xiaoli5201314-spec/rubber-tapping-robot-stm32-rk3588/firmware/chassis_f407/README_CN.md

# STM32F407 履带底盘遥控固件

本工程是一个面向 STM32F407 的双路 D60A 电机驱动固件：接收遥控器 CH1（转向）、CH2（油门）和 CH5（解锁），经过安全状态机后驱动左、右两个直流电机。串口会输出输入信号、安全状态和两路输出，便于调试。

## 首版范围

- 支持 50 Hz 模拟舵机脉宽输入：CH1、CH2、CH5。
- 支持 D60A 两路方向 + PWM 控制，MA 为左电机，MB 为右电机。
- 上电默认锁定；CH1/CH2 回中、CH5 解锁并保持中立 1 秒后才允许驱动。
- 输入失效、超时或捕获溢出时立即刹车；重新恢复后必须先断开 CH5，再重新完成中立保持。
- 默认输出上限为 30%，换向时先降到零并刹车 50 ms。
- USART1 以 115200 波特率输出诊断行；没有编码器，因此只能把 PWM 输出百分比当作“输出量”，不能当作实际速度。

以下功能不属于首版：LCD/触摸、雷达、视觉、切割机构等。首版电机引脚与板上的摄像头/OLED 接口复用，请不要同时连接这些模块。

## 快速开始

1. 先阅读 [Docs/WIRING_CN.md](Docs/WIRING_CN.md)，断开 24 V 电机电源，完成接线、P2 跳帽和共地检查。
2. 按 [Docs/TEST_GUIDE_CN.md](Docs/TEST_GUIDE_CN.md) 配置遥控器，并依次完成串口、无电机、抬高底盘和低速落地测试。
3. 使用工程现有的 Keil/STM32 工具编译并下载；串口终端选择 UART1、115200、8-N-1。
4. 上电顺序始终为：在接线和准备过程中先保持“发射机/接收机关闭”或“CH5 处于 disarm” → 给 STM32/接收机接通低压电源 → 通过串口确认 `LOCKED`/`FAILSAFE` 且两路为 `BRAKE` → 最后才接通带保险和急停的 24 V 电机母线。

> **安全警告**：首次通电必须拆下电机或让履带完全离地；现场应有保险丝、总电源开关和伸手可及的急停。绝不能把 24 V 直接接到 STM32 或接收机的 5 V/低压端。

详细连接关系见 [WIRING_CN.md](Docs/WIRING_CN.md)，分阶段上电和验收步骤见 [TEST_GUIDE_CN.md](Docs/TEST_GUIDE_CN.md)。
