xiaoli5201314-spec/rubber-tapping-robot-stm32-rk3588/docs/progress.md

# 项目进度

更新时间：2026-10-15。此页用于持续更新实际工作，分别记录软件检查、台架观察和未完成事项，不以“已有设计”代替实物验收。

| 部分 | 当前进度 | 边界 / 下一步 |
| --- | --- | --- |
| 自制 STM32F407 板 | 已开展焊接和上电检查，提供独立 LED 测试工程 | 不是整机长期可靠性验收 |
| USB / 调试串口 | 已完成 CH340N / UART 通信阶段检查，保留 UART4 检查源码 | 继续核对整机布线、共地和抗干扰 |
| ESP-12F、Wi-Fi、MQTT | 已建立 MQTT 联调主线，支持 SESSION、心跳、重连与 LED 自检 | 热点已关联、设备在线和本次自检成功分别判断 |
| 接收器 PWM | 已接入 CH1/CH2/CH5，完成输入和本地锁定/解锁逻辑开发 | 接收器自身失控保护须单独核验 |
| 履带底盘 | 已开展底盘离地遥控试验，提供失效停车和换向保护源码 | 未据此宣称带载地面行驶或整机作业通过 |
| 30% / 60% / 100% 输出 | 已开展三个 PWM 上限的对比测试并保留三个独立目标 | PWM 上限不等于车速、电流限制或实际负载能力 |
| 动力供电 | 已定位现有 24 V / 5.1 A 电源对后续带载测试的限制 | 尚未完成电池、电流裕量、保护及带载供电验收；常规后续试验优先按已记录的 60% 阶段方案审慎推进 |
| 电脑网页监视 | 已有实时状态、遥控/输出显示、离线撤销与受限 LED 自检 | 网页不发送运动、解锁或切割命令 |
| RK3588 / ROS 2 | Ubuntu 24.04 / ROS 2 Jazzy 软件环境已完成节点通信、C++ 编译运行、重启回连等软件侧检查 | 不代表传感器、实际串口或完整机器人系统已经接入 |
| 四柱升降机构 CAD | 已形成概念布局，保留 Fusion 生成脚本 | 导轨、丝杆、驱动、限深、防坠与加工图尚待工程化；不按概念模型直接加工 |
| 雷达、摄像头、视觉 / 导航 | 已有独立开发或方案准备 | 尚未在本割胶机器人完成实物集成和整车验收 |
| 割胶执行与胶层控制 | 尚未验证 | 需完成机构、限深/仿形、安全联锁与真实作业试验 |

## 已公开的工作

代码以当前工作文件整理：基础底盘、安全状态机、各板级检查工程、五个 MQTT 目标、Python 服务、网页界面、测试和机械概念脚本。原始私人对话、个人文档、论文、运行日志和厂商大包不随源码发布。

本次公开副本的软件回归结果在 [VALIDATION.md](VALIDATION.md)，与本页历史台架进度分别记录。本次发布没有再次连接硬件，也没有烧录或发送运动指令。

## 后续更新方式

每次完成新工作，更新上方日期和对应行，注明具体环境、验证方法和剩余限制；新的软件回归结果写入 `VALIDATION.md`。只有真实完成的硬件验收才将相应条目改为通过。
