xiaoli5201314-spec/rubber-tapping-robot-stm32-rk3588/firmware/chassis_f407/Docs/TEST_GUIDE_CN.md

# 安全上电与分阶段测试指南

本指南假设已经完成 [WIRING_CN.md](WIRING_CN.md) 的接线。每一步都要有保险丝、总开关和伸手可及的急停；任何人靠近履带时都必须先断开 24 V 母线。

## 遥控器设置

1. 发射机/接收机使用 **50 Hz 模拟舵机模式，180°**。
2. CH1 映射为转向，CH2 映射为油门；两者机械中位应约为 1500 us。
3. 将三段开关 SWA 映射到 CH5。默认高电平有效，CH5 脉宽达到 **1700 us 或更高**才算解锁。
4. 设定失控保护（failsafe）：CH1=1500 us、CH2=1500 us、CH5=disarm（低于 1700 us，例如约 1000 us）。
5. 首次接电机前，关闭发射机或关闭接收机，确认系统在串口中进入 FAILSAFE/锁定并保持刹车；确认后再继续。

固件要求 CH1、CH2、CH5 三路都有效且新鲜：先将 CH5 置于断开端并让 CH1/CH2 保持 1450–1550 us 中立进入 WAIT，连续保持 1 秒后再将 CH5 拨到解锁端，才会进入 ARMED。输入超时（默认 100 ms）、无效或捕获溢出会立即刹车；恢复信号后必须先将 CH5 置于断开端，再重新完成 1 秒中立保持。

## 串口诊断格式

UART1：115200、8-N-1。约每 200 ms 输出一行，字段包括：

`t` 时间；`ch1/ch2/ch5` 脉宽（us）；每路 `v` 有效标志、`f` 新鲜标志；`state` 为 `LOCKED`、`WAIT`、`ARMED` 或 `FAILSAFE`；`lt/rt` 左右目标输出；`ld/rd` 方向（`FWD`、`REV`、`BRAKE`）；`lp/rp` PWM 输出千分比；`fault` 故障原因。

没有编码器，`lp/rp` 只是控制输出百分比，不是实际转速。刹车在 D60A 上表现为方向输入 `00` 且 PWM=0。换向时先缓降到 0，再保持 50 ms 刹车后才允许反向；默认最大输出为 300‰（30%）。

## 分阶段测试

每一阶段都必须满足“预期现象”后才能进入下一阶段。出现任一停止条件，立即执行“急停动作”，记录串口最后一行，再断电排查。

### 1. 仅逻辑/串口测试（不接 24 V，不接电机）

**接线与电源状态**：电机从 D60A 脱开，24 V 母线断开；只给 STM32 和接收机低压供电，连接 USB-UART 到 UART1。P2 选 MCU 侧，接收机 GND 与 STM32 GND 共地。

**预期遥测**：接收机关闭或发射机关闭时三路 `v/f` 不全为 1，`state=LOCKED` 或 `FAILSAFE`，`ld=rd=BRAKE` 且 `lp=rp=0`；打开并保持遥控器中立、CH5 断开时先看到 `WAIT`，持续 1 秒后把 CH5 拨到解锁端才看到 `ARMED`。此时即使遥控杆移动，因没有 24 V 和电机也不应有机械动作。

**停止条件与急停**：串口出现输入异常跳变、任何一路 `v=0` 却进入 ARMED、或 LED 与 `state` 不一致，立即关闭低压电源，检查 P2、共地、接收机模式和信号线。不要进入下一阶段。

### 2. D60A 驱动测试（不接电机）

**接线与电源状态**：保持电机断开；接好 D60A 控制排针 2/3/4/5/7/8/9/10，1/6 留空；控制地共地。仅给 STM32、接收机和 D60A 控制侧低压供电，24 V 母线仍断开。

**预期遥测**：安全流程与阶段 1 相同。保持 ARMED 后缓慢拨动 CH1/CH2，`lt/rt` 应按预期正负变化，`ld/rd` 在 FWD/REV 间切换，`lp/rp` 从 0 逐步变化且不超过 300；回中后回到 BRAKE/0。D60A 输出端不应有电机动作。

**停止条件与急停**：任一路方向线与预期相反、PWM 不归零、输出超过 300‰、或未 ARMED 时出现非 BRAKE，立即把 CH5 拨回断开端并切断低压电源；核对 A/B 方向线、PWM 线和 D60A 端子编号。

### 3. 单电机测试（底盘抬起）

**接线与电源状态**：安装并固定 MA（左电机）或 MB（右电机）中的一个，另一个电机线保持断开并绝缘；履带完全离地。控制低压电源先上，确认串口 LOCKED/WAIT；再通过保险丝和急停接通 24 V 母线。

**预期遥测**：CH5 断开、CH1/CH2 中立时必须保持 BRAKE/0。完成解锁后，用很小的油门并按需配合转向短点动；已接电机应按对应方向低速启动，PWM 平滑递增，回中后降到 BRAKE/0。由于固件在 ARMED 时始终同时计算和应用左右两路，遥测中的 `lt/rt`、`lp/rp` 可能两侧都有指令；判断单电机测试通过的条件是物理上已断开的一侧不应转动，而不是要求该侧遥测为 0。关闭发射机或拔掉接收机信号后应立即 FAILSAFE 和刹车。

**停止条件与急停**：电机抖动、持续自转、方向与预期相反、D60A/电机异常发热、保险丝动作、串口出现 FAILSAFE 以外的故障，或电机无法刹停时，立即拨回 CH5、按急停、断开 24 V，再断低压。更换接线前等待电机完全停止。

### 4. 双电机测试（底盘抬起）

**接线与电源状态**：MA 接左路，MB 接右路；底盘稳固抬起，履带不得接触地面。低压先上并确认遥测正常，再接通带保险的 24 V 母线。

**预期遥测**：油门中立时两路 BRAKE/0；仅推油门时 `lt` 与 `rt` 同号且两路 PWM 随斜坡同步增加；仅推转向时两路目标一正一负或一侧减小，方向符合左右履带差速。快速反向时每一路先降到零、刹车约 50 ms，再反向。任何时刻输出不超过 300‰。

**停止条件与急停**：任一侧不同步到无法解释、方向颠倒、换向无刹车、机械碰撞/异常噪声/发热，立即 CH5 断开并按急停。若掉链或结构松动，先断 24 V，禁止用手扶正在转动的履带。

### 5. 低速落地测试

**接线与电源状态**：确认前四阶段通过；底盘放到空旷平整地面，人员站在履带侧后方而非前方。保留保险丝、总开关和急停；低压上电确认 LOCKED/WAIT 后，再接通 24 V。

**预期遥测**：先以最小油门短点动，底盘应按 CH2 前后、CH1 转向移动；松杆回中后两路降为 BRAKE/0。逐步增加时间而不是幅度，始终观察 `state`、`fault`、`lp/rp`，不得把输出百分比当作速度。关闭发射机测试时应在 100 ms 级别内进入 FAILSAFE 并刹车。

**停止条件与急停**：方向无法控制、回中后仍爬行、任何信号 `v/f` 丢失、FAILSAFE 未刹停、温升/异味/异响或人员进入危险区，立即松开遥控器、拨 CH5、按急停并切断 24 V。查明原因并重新从阶段 1 开始，不要直接恢复行驶。

## 可调参数（`App/board_config.h`）

修改后必须重新编译、下载，并重复至少阶段 1–3 的安全验证。

| 符号 | 默认值 | 用途 |
| --- | ---: | --- |
| `RC_STEERING_INVERT` | `0` | CH1 转向方向反相开关 |
| `RC_THROTTLE_INVERT` | `0` | CH2 油门方向反相开关 |
| `MOTOR_LEFT_INVERT` | `0` | 左电机 MA 输出方向反相 |
| `MOTOR_RIGHT_INVERT` | `0` | 右电机 MB 输出方向反相 |
| `RC_CENTER_US` | `1500` | CH1/CH2 中位（us） |
| `RC_DEADBAND_US` | `50` | 中位死区，默认 1450–1550 us |
| `RC_ARM_ACTIVE_HIGH` | `1` | CH5 有效极性；1 表示高脉宽有效 |
| `RC_ARM_THRESHOLD_US` | `1700` | 高有效时 CH5 解锁阈值（us） |
| `RC_TIMEOUT_MS` | `100` | 遥控输入超时（ms） |
| `MOTOR_MAX_OUTPUT_PERMILLE` | `300` | 最大 PWM 输出（千分比） |
| `MOTOR_RAMP_STEP_PER_10MS` | `10` | 每 10 ms 的输出斜坡步长 |
| `MOTOR_REVERSE_BRAKE_MS` | `50` | 换向前归零后的刹车时间（ms） |
| `RC_ARM_NEUTRAL_HOLD_MS` | `1000` | 解锁前 CH1/CH2 中立保持时间（ms） |

不要为了“方便测试”删除安全状态机、绕过 CH5 或把超时设为极大值。任何参数变更都应在抬高底盘状态下重新验证失控保护。
