xiaoli5201314-spec/rubber-tapping-robot-stm32-rk3588/firmware/chassis_f407/Docs/WIRING_CN.md

# 接线说明（STM32F407 自绘底板 + 布瑞特 BRT-HDC-D60A）

本文按“第一次接线”的顺序编写，对应 `选取的stm32/自己已经画的STM32F407的部分/SCH_Schematic1_2026-09-30.pdf`。所有电源关闭、24 V 母线断开并拔掉电机后再改线。

## 重要安全规则

- 24 V 只供电机母线和 D60A 的电机功率侧；STM32 和接收机使用独立、合适的低压电源。
- STM32、接收机和 D60A 控制信号的 GND 必须共地，否则 PWM/方向信号可能漂移或失控。
- 绝不能把 24 V 接到 STM32、接收机 5 V 或任何 MCU 引脚。
- 在电源入口安装符合电流需求的保险丝、总开关和可触及的急停；首次电机测试时底盘必须抬离地面。
- 本固件占用 `CN1`（电机驱动）与 `CN3`（遥控器）两个端子；LCD 座、`U8` I2C1 排针、`J1` 机构口、蜂鸣器、WiFi 模块均不在首版范围内。
- ⚠️ 板上 `U8` 4P 排针引出的是 `I2C1_SCL`/`I2C1_SDA`（已核对为 **PB8/PB9**）。**以后配置 I2C1 时绝不能改到 PB6/PB7**——那两个脚是左右电机的 PWM（TIM4_CH1/CH2），改过去会立刻废掉两路电机驱动。
- ⚠️ 不要把 LCD 触摸（本板触摸脚 29–34 未接）、雷达、视觉和切割模块接进首版固件的引脚。

## 接收机与 STM32

自绘 PCB 上对应 **`CN3` = `DB128V-5.08-5P-GN-S`（5 位端子）**。

| CN3 脚 | 接收机信号 | 网络名 | STM32 引脚 | 用途 |
| ---: | --- | --- | --- | --- |
| 1 | CH1 信号 | `RC_CH1` | PB10 / TIM2_CH3 | 转向 |
| 2 | CH2 信号 | `RC_CH2` | PB11 / TIM2_CH4 | 油门 |
| 3 | CH5 信号 | `RC_CH5` | PF6 / TIM10_CH1 | 解锁/安全开关（SWA） |
| 4 | 5 V | `5V` | — | 接收机供电 |
| 5 | GND | `GND` | — | 与 STM32、D60A 控制地共地 |

**CH5 必须接到 CN3-3**。遥控器把三段开关 SWA 映射到 CH5；先拨到三个位置，用串口确认你打算当“解锁”的那一端脉宽 ≥1700 µs（`board_config.h` 的 `RC_ARM_THRESHOLD_US`），若极性相反就把 `RC_ARM_ACTIVE_HIGH` 改成 `0U`。

固件的 100 ms 超时检查的是“最后有效 PWM”，**并不直接检测遥控器无线失联**。若关掉遥控器后接收机继续保持合法 PWM，固件不会仅因无线断联进入 `FAILSAFE`。说明书有失控保护说明，但本套 F-10A 的实际输出必须先实测：分别验证“关闭发射机”和“断开信号线”；接电机前还必须验证接收器失控保护和硬件急停。

**PWM 输入电平条件：**PB10/PB11/PF6 为 FT 引脚，固件使用数字定时器输入并关闭内部上下拉（`GPIO_NOPULL`），以满足可能为 5 V 的输入要求。ST 数据手册第 78 页要求高于 `VDD+0.3 V` 的输入必须关闭内部上下拉；建议 MCU 侧每路外接约 10 kΩ 下拉到 GND，防止断线后悬空。没装外部下拉时，不应将拔线现象作为失效保护验证结论。接收机本次只用 5 V 供电，不能把 4–9 V 供电范围理解为 MCU 可接受的信号范围。

<details>
<summary>旧版探索者底板遗留说明（自绘 PCB 已不适用）</summary>

探索者 V3 原板的 P2 为 PB10/PB11 在 RS232 与 ATK-MODULE 之间选择连接；直接飞线到 PB10/PB11 时，应断开这些跳帽以隔离外设。PF6 连接 ATK-MODULE KEY，不经过 P2，不要同时连接该模块。自绘 PCB 用独立的 `CN3`（5P 端子）引出 `RC_CH1 / RC_CH2 / RC_CH5 / 5V / GND`，不套用原板跳帽说明。当前原开发板桌面测试另见 `RC_BENCH_TEST_CN.md`。
</details>

**接收机必须工作在「模拟舵机模式 50 Hz」**（HT-10A 说明书 P11）：该模式输出周期 20 ms、脉宽 1000–2000 µs。数字舵机模式为 330 Hz、周期 3.03 ms，会超出固件 15–25 ms 的捕获窗口，导致三路输入全部无效、底盘永远无法解锁。遥控器菜单里确认「舵机频率 50 Hz、舵机角度 180°」。

**接收机供电范围 DC 4–9 V**（说明书 P12），本板 `CN3-4` 提供 5 V，符合要求；不得接入 24 V 母线。

**必须使用 PWM 接收机（F-10A）**。随附的 SBUS 接收机本固件不支持（SBUS 为 100000-8E2 反相串口，需要外部反相电路与专门的帧解析代码，当前工程未实现）。

接收机 5 V 由稳定的低压电源提供；接收机 GND、STM32 GND、D60A 控制端的 GND 必须连在同一个地参考上。D60A 控制排针上的 5 V 输出脚不是本说明中的接收机供电脚，见下表，1 和 6 脚保持断开。

## D60A 十针控制排针

自绘 PCB 上用 **`CN1` = `DB128V-5.08-7P-GN-S`（7 位端子）** 引出 6 根信号线 + GND；D60A 侧 1/6 脚两个 5 V 输出**在板上没有引出**，与“必须留空”的要求天然一致。

按 D60A 排针编号接线。**1 脚和 6 脚即使标为 5 V 也必须留空，不要插线。**

| D60A 针脚 | 板端信号 | STM32 端点 | CN1 脚 | 连接/说明 |
| ---: | --- | --- | ---: | --- |
| 1 | 5 V 输出 | — | — | **断开** |
| 2 | PB 右 PWM | PB7 / TIM4_CH2 | 4 | 右路 PWM（对应 MB） |
| 3 | B1 | PE5 | 5 | 右路方向 B1 |
| 4 | B2 | PE6 | 6 | 右路方向 B2 |
| 5 | GND | GND | 7 | 控制信号地，接共地 |
| 6 | 5 V 输出 | — | — | **断开** |
| 7 | PA 左 PWM | PB6 / TIM4_CH1 | 1 | 左路 PWM（对应 MA） |
| 8 | A1 | PD6 | 2 | 左路方向 A1 |
| 9 | A2 | PD7 | 3 | 左路方向 A2 |
| 10 | GND | GND | 7 | 控制信号地，接共地 |

表中的 PA/PB 是 D60A 驱动排针的 A/B 路标识，不是 STM32 的 GPIO 端口名称；请按“STM32 端点”一列接线。本固件的逻辑分配是：PA 左 PWM、A1/A2 控制左路 MA；PB 右 PWM、B1/B2 控制右路 MB。若 D60A 外壳丝印与排针顺序不一致，以实际 1–10 编号和本表为准，不要自行交换 A/B。

**PWM 频率（2026-10-12 更正）**：当前 `Src/tim.c` 的 `MX_TIM4_Init` 是 `Prescaler=83, Period=99`；当前8 MHz外部晶振、168 MHz系统时钟和APB1四分频下，TIM4时钟为84 MHz，因此输出频率为84 MHz ÷ (83 + 1) ÷ (99 + 1) = **10 kHz**。
驱动器说明书给出的上限是 **60 kHz**，§3.1 示例用的是 **10 kHz**，当前频率符合该范围，无需为此修改程序。
旧版此处误算为100 kHz，并建议把分频值改为839；该建议撤回，839实际会得到1 kHz。TIM2负责遥控输入的1 µs捕获分辨率，也不需要改动。

**控制逻辑电平**：D60A 支持 3.3 V 控制信号（说明书 §1.2），STM32 的 3.3 V 推挽输出可直接驱动。方向输入悬空时为低电平，本固件始终显式写电平，不依赖悬空状态。

**换向要求**：说明书 §3 注 3 要求“大能量正反转切换时应先 PWM 逐步调速至 0% 再切换”。本固件的 `motor_profile.c` 已实现：先斜坡降到 0，保持 50 ms 刹车，再换向。

## 电机与电源

- MA 接左侧履带电机，MB 接右侧履带电机。
- 24 V 电机母线接 D60A 的功率输入，按 D60A 额定电压、电流和极性接线，并串入保险丝和总开关。
- STM32/接收机低压电源单独供电；只把信号地与 D60A 控制地相连，不把 24 V 母线引入低压系统。
- 所有接头固定、绝缘并防止履带运动时拉脱。改变任一方向线前，先断开低压电源和 24 V 母线。

## 指示灯与串口

PF9 红灯和 PF10 绿灯均为低电平点亮：锁定、等待中立或故障时红灯亮；进入 ARMED 后绿灯亮。UART1 为 115200 波特率，连续输出诊断行，可在不接电机时先验证输入和安全状态。
