xiaoli5201314-spec/rubber-tapping-robot-stm32-rk3588/firmware/chassis_f407/Inc/main.h

#define LED0_Pin GPIO_PIN_9
#define LED0_GPIO_Port GPIOF
#define LED1_Pin GPIO_PIN_10
#define LED1_GPIO_Port GPIOF
#define RC_CH1_Pin GPIO_PIN_10
#define RC_CH1_GPIO_Port GPIOB
#define RC_CH2_Pin GPIO_PIN_11
#define RC_CH2_GPIO_Port GPIOB
#define RC_CH5_Pin GPIO_PIN_6
#define RC_CH5_GPIO_Port GPIOF
#define MOTOR_LEFT_PWM_Pin GPIO_PIN_6
#define MOTOR_LEFT_PWM_GPIO_Port GPIOB
#define MOTOR_RIGHT_PWM_Pin GPIO_PIN_7
#define MOTOR_RIGHT_PWM_GPIO_Port GPIOB
#define MOTOR_LEFT_IN1_Pin GPIO_PIN_6
#define MOTOR_LEFT_IN1_GPIO_Port GPIOD
#define MOTOR_LEFT_IN2_Pin GPIO_PIN_7
#define MOTOR_LEFT_IN2_GPIO_Port GPIOD
#define MOTOR_RIGHT_IN1_Pin GPIO_PIN_5
#define MOTOR_RIGHT_IN1_GPIO_Port GPIOE
#define MOTOR_RIGHT_IN2_Pin GPIO_PIN_6
#define MOTOR_RIGHT_IN2_GPIO_Port GPIOE
#define USART1_TX_Pin GPIO_PIN_9
#define USART1_TX_GPIO_Port GPIOA
#define USART1_RX_Pin GPIO_PIN_10
#define USART1_RX_GPIO_Port GPIOA
