xiaoli5201314-spec/rubber-tapping-robot-stm32-rk3588/firmware/chassis_f407/App/motor_driver.h

#ifndef MOTOR_DRIVER_H
#define MOTOR_DRIVER_H

#include "motor_profile.h"

void MotorDriver_Init(void);
void MotorDriver_ApplyLeft(MotorOutput output);
void MotorDriver_ApplyRight(MotorOutput output);
void MotorDriver_EmergencyBrake(void);

#endif /* MOTOR_DRIVER_H */
