xiaoli5201314-spec/rubber-tapping-robot-stm32-rk3588/firmware/chassis_f407/Inc/usart.h

#ifndef __USART_H
#define __USART_H

#ifdef __cplusplus
extern "C" {
#endif

#include "stm32f4xx_hal.h"

extern UART_HandleTypeDef huart1;

void MX_USART1_UART_Init(void);

#ifdef __cplusplus
}
#endif

#endif /* __USART_H */
