xiaoli5201314-spec/rubber-tapping-robot-stm32-rk3588/firmware/board_web_link_test_f407/Inc/motor_web.h

#ifndef MOTOR_WEB_H
#define MOTOR_WEB_H
#include <stdint.h>

/* Change one side only after an isolated, powered-off direction check. */
#define WEB_MOTOR_LEFT_INVERT  0U
#define WEB_MOTOR_RIGHT_INVERT 0U

uint8_t MotorWeb_Init(void);
void MotorWeb_Apply(int16_t left, int16_t right);
void MotorWeb_Stop(void);
void MotorWeb_FeedWatchdog(void);

#endif
