xiaoli5201314-spec/rubber-tapping-robot-stm32-rk3588/firmware/board_web_link_test_f407/Inc/mux_parser.h

#ifndef MUX_PARSER_H
#define MUX_PARSER_H
#include <stdint.h>
typedef void (*MuxLineCallback)(const char *);
typedef void (*MuxDataCallback)(uint8_t link, uint8_t byte);
typedef void (*MuxPromptCallback)(void);
void MuxParser_Init(MuxLineCallback line, MuxDataCallback data, MuxPromptCallback prompt);
void MuxParser_Reset(void);
void MuxParser_Feed(uint8_t byte);
uint32_t MuxParser_Errors(void);
#endif
